Z3r0shin/GERARD/hardware/README.md

# GERARD hardware

Hardware revision A. Start with the schematic PDF.

| File | What |
|---|---|
| [`kicad/gerard - Schematic.pdf`](kicad/gerard%20-%20Schematic.pdf) | The schematic, one US Letter sheet. Open this first. |
| [`kicad/gerard.kicad_sch`](kicad/gerard.kicad_sch) | The schematic's KiCad 9 source |
| [`kicad/gerard.kicad_pro`](kicad/gerard.kicad_pro) | The KiCad project file |
| [`kicad/gerard.kicad_sym`](kicad/gerard.kicad_sym), [`kicad/sym-lib-table`](kicad/sym-lib-table) | The project's own symbol library |
| [`GERARD - BoM.csv`](GERARD%20-%20BoM.csv) | The bill of materials: every part to buy or print, with its quantity |
| [`3d/GERARD top.stl`](3d/GERARD%20top.stl), [`3d/GERARD bottom.stl`](3d/GERARD%20bottom.stl) | The enclosure, two parts |
| [`3d/Knob FINAL.stl`](3d/Knob%20FINAL.stl) | The knob |

Parts, circuits and wiring are explained in the Hardware Bible, in [`../docs/`](../docs/).
Back to the [main README](../README.md).
