Z3r0shin/GERARD/docs/README.md

# GERARD documents

The two books of GERARD, each as a PDF for a person and as Markdown for an LLM. Start with the Hardware Bible PDF.

| File | What |
|---|---|
| [`GERARD - Hardware Bible.pdf`](GERARD%20-%20Hardware%20Bible.pdf) | Parts, circuits, wiring and enclosure. Open this first. |
| [`GERARD - Firmware Gospel.pdf`](GERARD%20-%20Firmware%20Gospel.pdf) | What the firmware does, pins, build and flash, settings, serial portal, faults |
| [`hardware-bible.md`](hardware-bible.md) | The Hardware Bible as Markdown |
| [`firmware-gospel.md`](firmware-gospel.md) | The Firmware Gospel as Markdown |
| [`figures/`](figures/) | The photos, the schematic as SVG (whole and by box), and the cable drawing with its WireViz source |

Back to the [main README](../README.md).
