Z3r0shin/GERARD/docs/figures/gerard-views.png

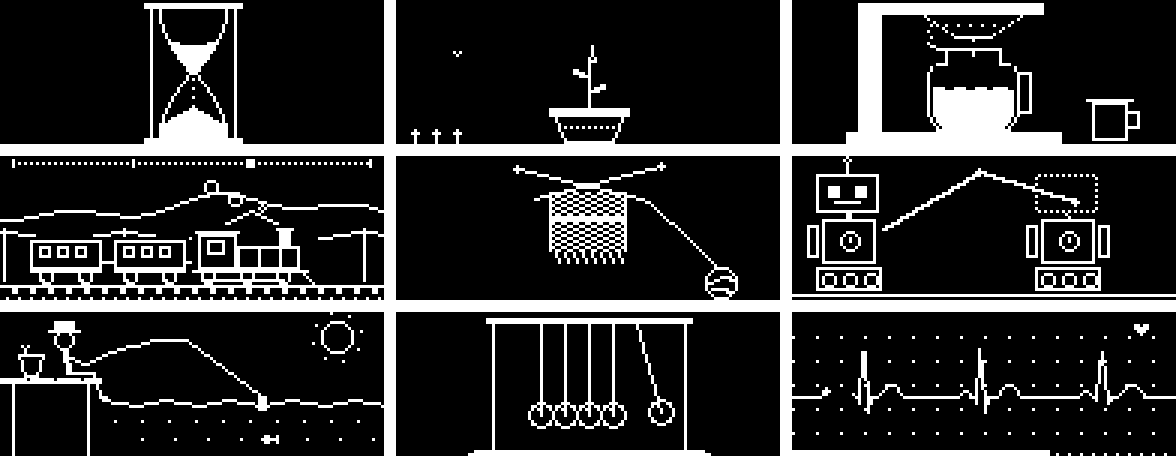
docs/figures/gerard-views.png
