Z3r0shin/GERARD/hardware/3d/Knob FINAL.stl

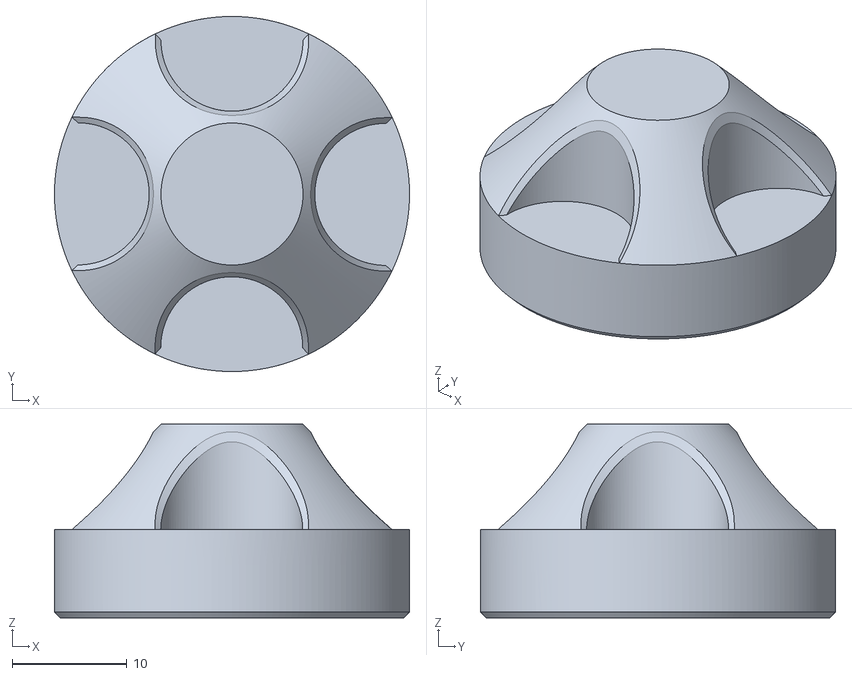
[picture p19: CAD file, 2026-11-10]
hardware/3d/Knob FINAL.stl
30.9 x 30.9 x 16.8
