Z3r0shin/GERARD/hardware/3d/GERARD bottom.stl

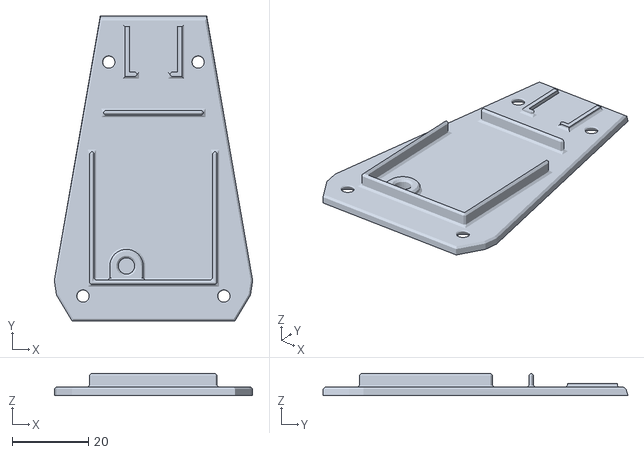
[picture p20: CAD file, 2026-11-10]
hardware/3d/GERARD bottom.stl
52.2 x 80.2 x 5.80
