Z3r0shin/GERARD/hardware/3d/GERARD top.stl

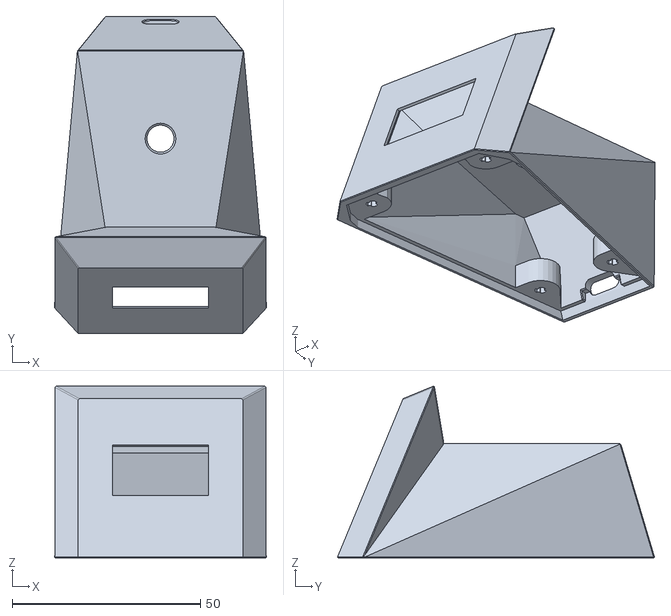
[picture p21: CAD file, 2026-11-10]
hardware/3d/GERARD top.stl
56.4 x 84.1 x 45.6
