Z3r0shin/GERARD/hardware/kicad/gerard - Schematic.pdf

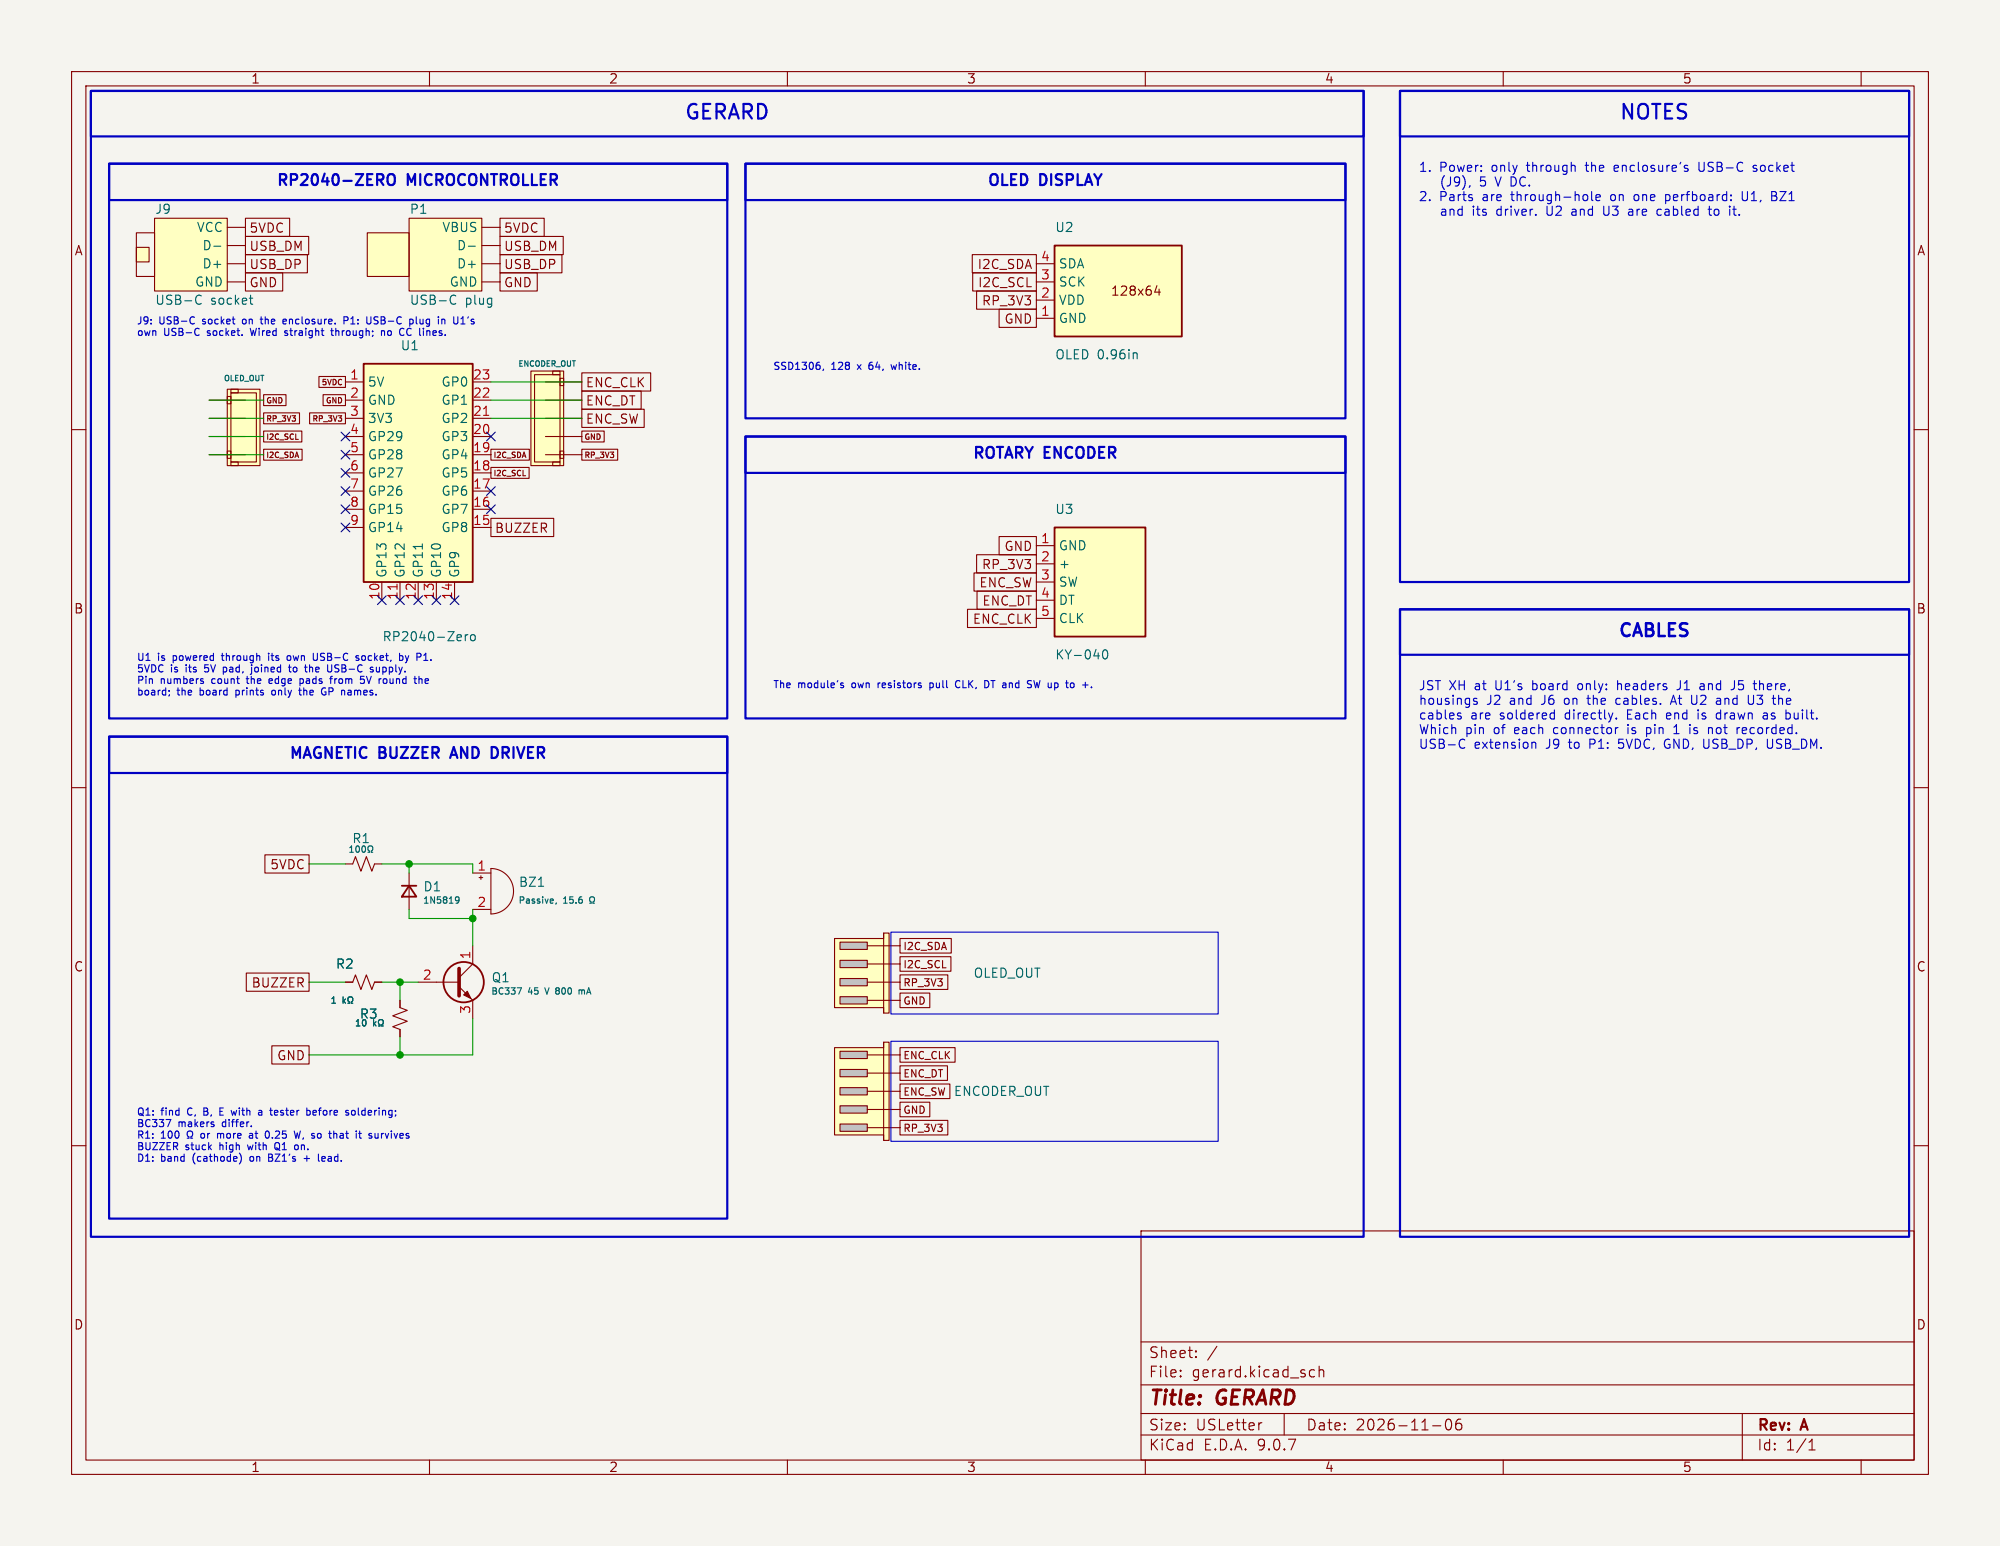
[picture p22: page 1]

MAGNETIC BUZZER AND DRIVER
