Z3r0shin/GERARD/hardware/kicad/gerard.kicad_sch

## KiCad design hardware/kicad/gerard.kicad_sch (2026-11-10)

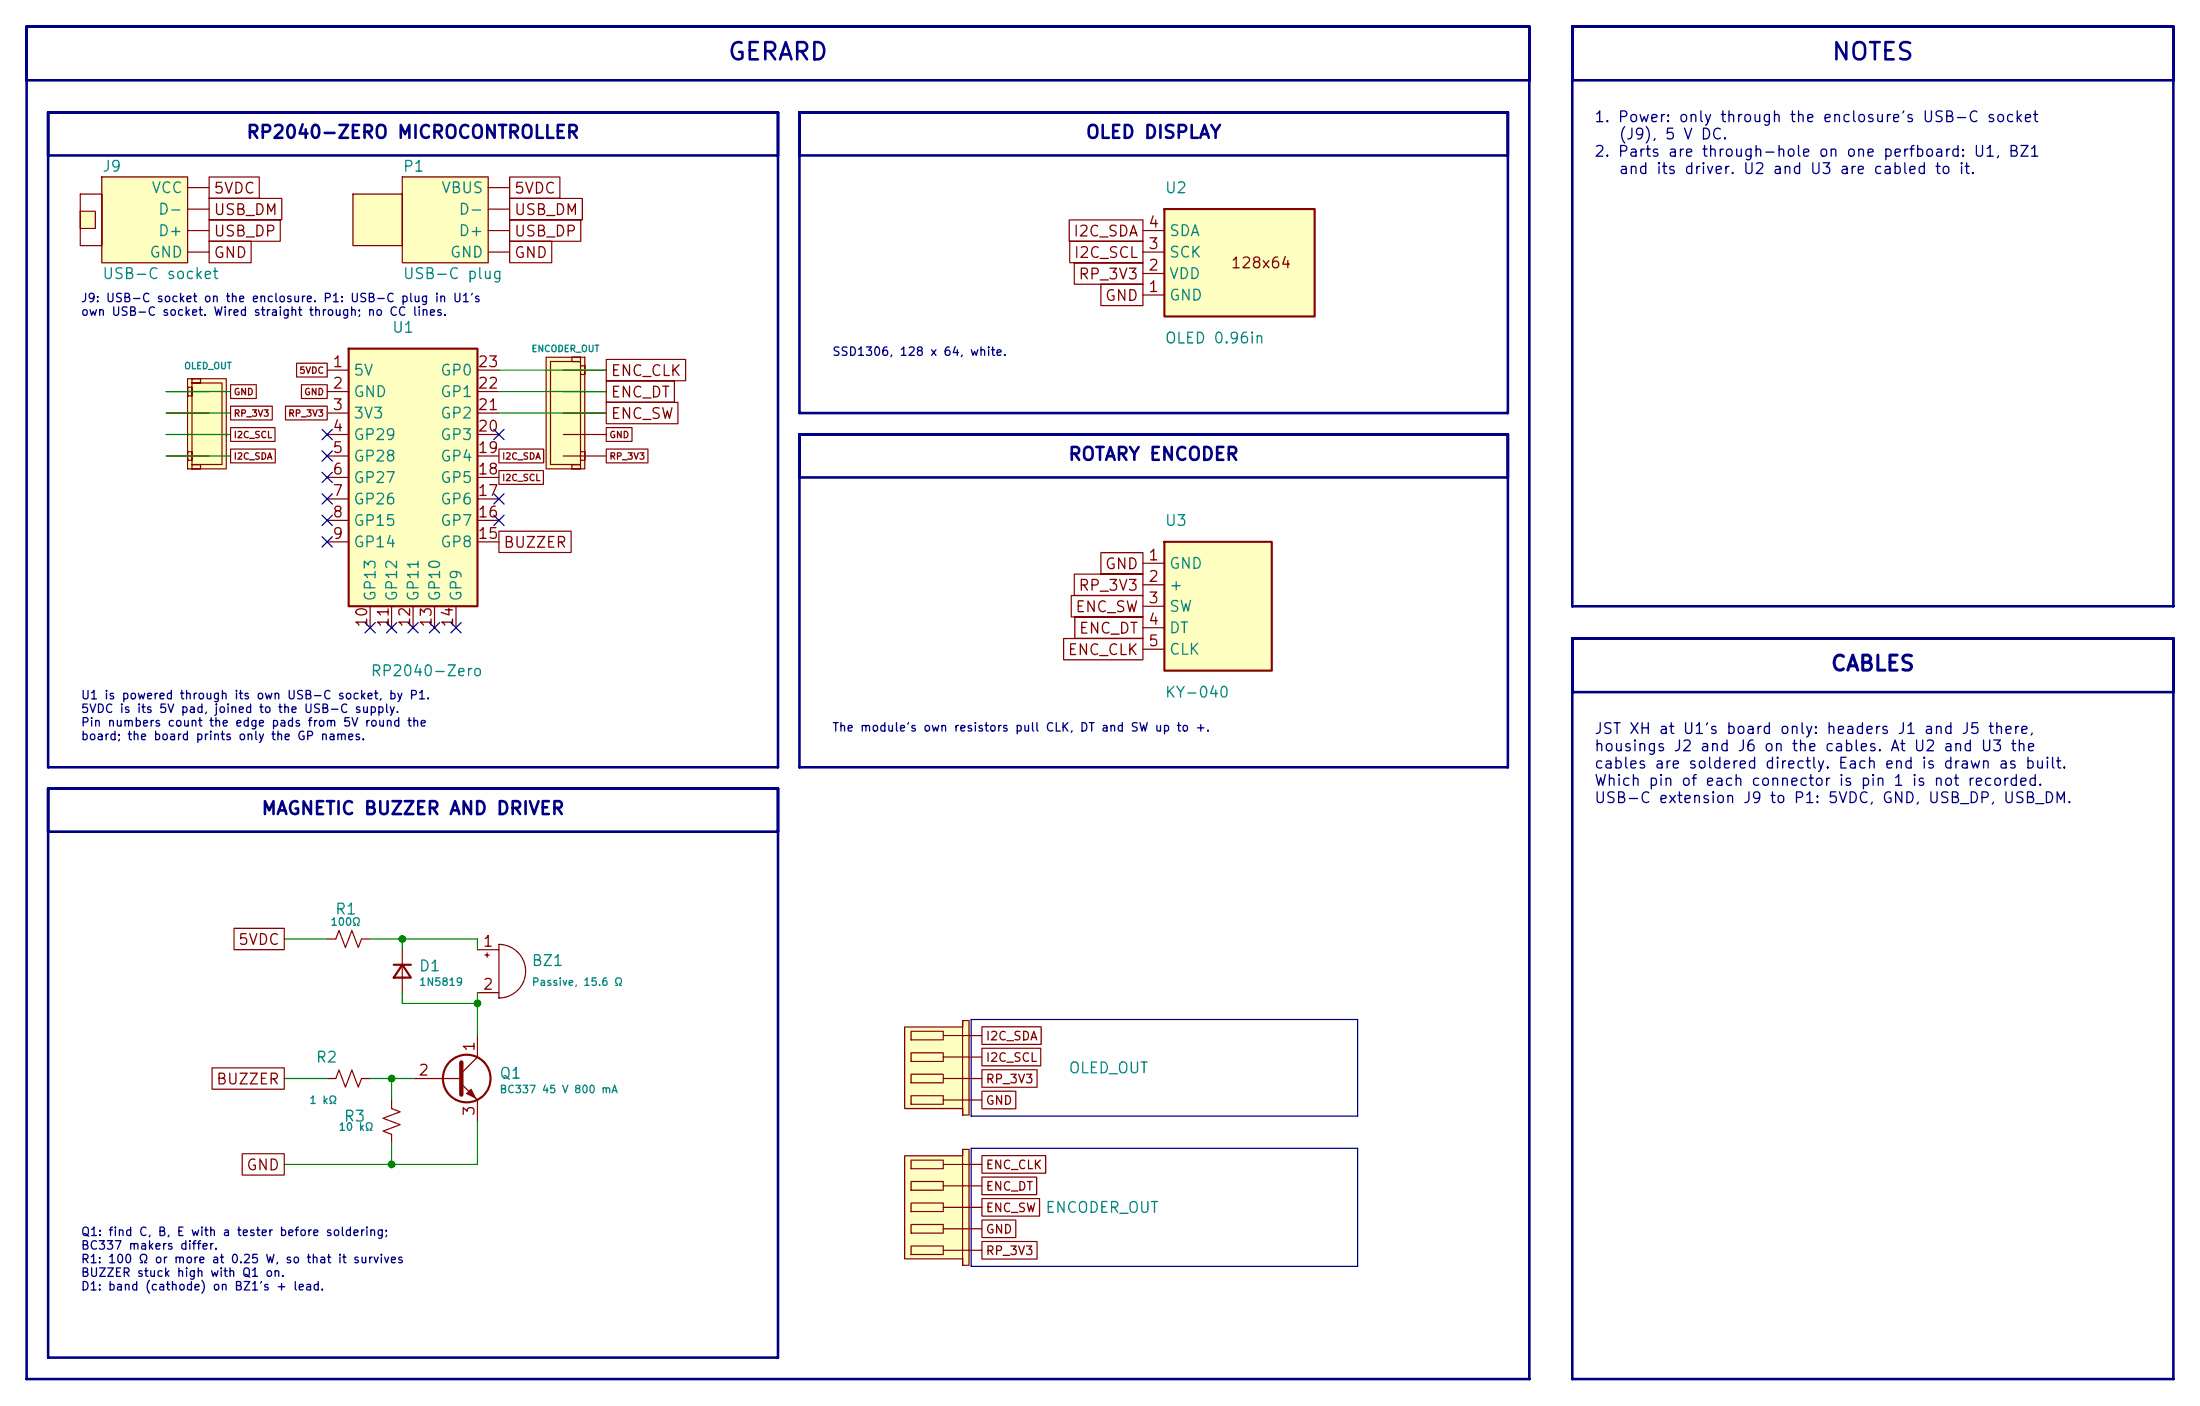
[picture p23: schematic gerard.kicad_sch]

Parts:
BZ1: Passive, 15.6 Ω
D1: 1N5819; D_DO-41_SOD81_P10.16mm_Horizontal
J1, J2: OLED_OUT
J5, J6: ENCODER_OUT
J9: USB-C socket
P1: USB-C plug
Q1: BC337 45 V 800 mA; TO-92_Inline
R1: 100Ω; R_Axial_DIN0207_L6.3mm_D2.5mm_P7.62mm_Horizontal
R2: 1 kΩ; R_Axial_DIN0207_L6.3mm_D2.5mm_P7.62mm_Horizontal
R3: 10 kΩ; R_Axial_DIN0207_L6.3mm_D2.5mm_P7.62mm_Horizontal
U1: RP2040-Zero
U2: OLED 0.96in
U3: KY-040

Connections:
5VDC: J9.VCC, P1.VBUS, R1.1, U1.1 (5V)
BUZZER: R2.1, U1.15 (GP8)
ENC_CLK: J5., J6., U1.23 (GP0), U3.5 (CLK)
ENC_DT: J5., J6., U1.22 (GP1), U3.4 (DT)
ENC_SW: J5., J6., U1.21 (GP2), U3.3 (SW)
GND: J1., J2., J5., J6., J9.GND, P1.GND, Q1.3 (E), R3.2, U1.2 (GND), U2.1 (GND), U3.1 (GND)
I2C_SCL: J1., J2., U1.18 (GP5), U2.3 (SCK)
I2C_SDA: J1., J2., U1.19 (GP4), U2.4 (SDA)
unnamed: BZ1.1 (+), D1.1 (K), R1.2
unnamed: BZ1.2 (-), D1.2 (A), Q1.1 (C)
unnamed: Q1.2 (B), R2.2, R3.1
RP_3V3: J1., J2., J5., J6., U1.3 (3V3), U2.2 (VDD), U3.2 (+)
USB_DM: J9.D-, P1.D-
USB_DP: J9.D+, P1.D+

Notes on the sheet:
J9: USB-C socket on the enclosure. P1: USB-C plug in U1's own USB-C socket. Wired straight through; no CC lines.
U1 is powered through its own USB-C socket, by P1. 5VDC is its 5V pad, joined to the USB-C supply. Pin numbers count the edge pads from 5V round the board; the board prints only the GP names.
NOTES
OLED DISPLAY
SSD1306, 128 x 64, white.
RP2040-ZERO MICROCONTROLLER
JST XH at U1's board only: headers J1 and J5 there, housings J2 and J6 on the cables. At U2 and U3 the cables are soldered directly. Each end is drawn as built. Which pin of each connector is pin 1 is not recorded. USB-C extension J9 to P1: 5VDC, GND, USB_DP, USB_DM.
1. Power: only through the enclosure's USB-C socket (J9), 5 V DC. 2. Parts are through-hole on one perfboard: U1, BZ1 and its driver. U2 and U3 are cabled to it.
ROTARY ENCODER
Q1: find C, B, E with a tester before soldering; BC337 makers differ. R1: 100 Ω or more at 0.25 W, so that it survives BUZZER stuck high with Q1 on. D1: band (cathode) on BZ1's + lead.
MAGNETIC BUZZER AND DRIVER
The module's own resistors pull CLK, DT and SW up to +.
CABLES
GERARD
