Z3r0shin/GERARD/firmware/src/input.h

// SPDX-License-Identifier: GPL-3.0-or-later
// GERARD firmware: the rotary encoder and its push button.
#pragma once

#include <stdint.h>

enum class ButtonEvent : uint8_t {
    None,
    Down,   // the button has just gone down (for the click sound)
    Short,  // released before the hold time
    Long,   // held for the hold time (fires once, while still held)
};

namespace input {

void begin();

// Detents turned since the last call: positive clockwise, negative anticlockwise.
int takeDetents();

// Call often from the main loop. Returns at most one event per call.
ButtonEvent pollButton(uint32_t now);

// true: turning the knob counts the other way round from ENC_DIRECTION.
void setReversed(bool reversed);

// How long a press must be held to count as a hold ("back").
void setHoldMs(uint32_t ms);

// Raw levels, for the serial portal.
bool clkLevel();
bool dtLevel();
bool swLevel();

}  // namespace input
