Z3r0shin/GERARD/(commit log)

2026-11-10 GERARD version 1
    Release version 1 of GERARD, a desk focus timer: hardware revision A and
    firmware v.1.0.20261109T161718Z. Schematic, enclosure and knob STL files,
    firmware source, the Hardware Bible and the Firmware Gospel as PDF and
    Markdown, photos, and the licence texts.
    [GERARD bottom.stl, GERARD top.stl, Knob FINAL.stl, gerard.kicad_sch]
2026-11-11 Revise README for clarity and formatting
    Updated the README to clarify the device name and its purpose, and improved formatting and wording throughout.
2026-11-12 Add the bill of materials
    hardware/GERARD - BoM.csv lists every part to buy or print, with its
    quantity. Linked from the README, hardware/README.md, llms.txt and the
    Hardware Bible.
    [GERARD - BoM.csv]
